Exeu/BLESEN/PCB.png

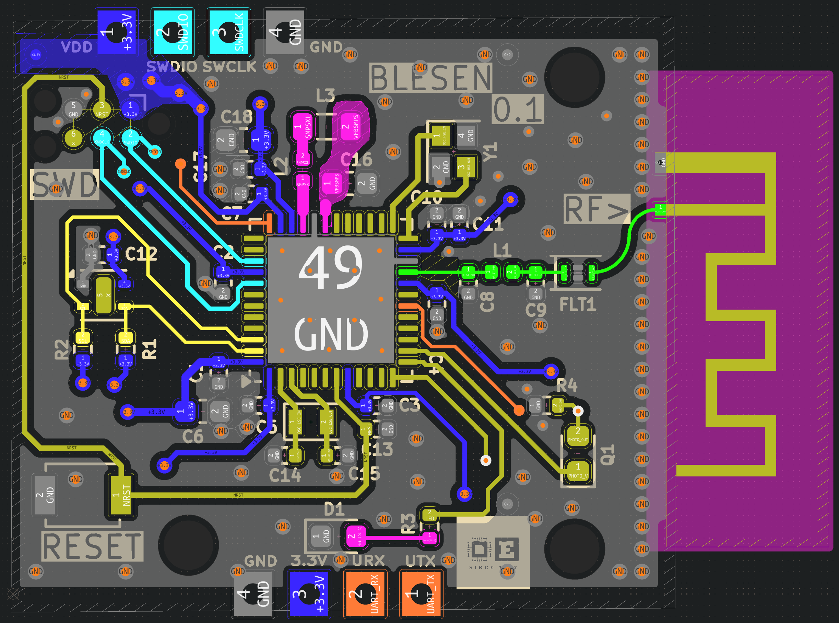
PCB.png
