Exeu/BLESEN/models/HT_CD_SHTC3_STEP_File_V1_D1 v2.step

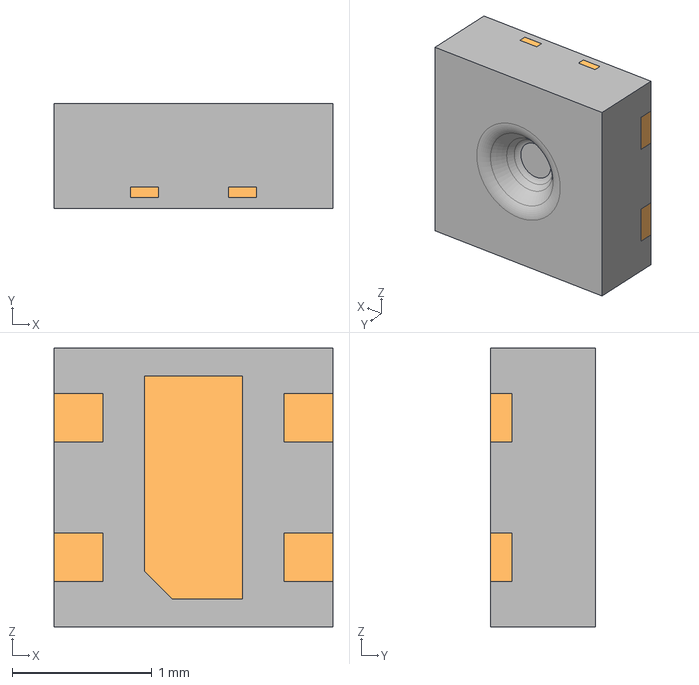
[picture p2: CAD file, 2025-02-23]
models/HT_CD_SHTC3_STEP_File_V1_D1 v2.step
2.00 x 0.75 x 2.00 mm
