Exeu/BLESEN/(list of files, cad)

Other CAD files:
models/HT_CD_SHTC3_STEP_File_V1_D1.STEP
