Exeu/BLESEN/BLESEN-Schematic.pdf

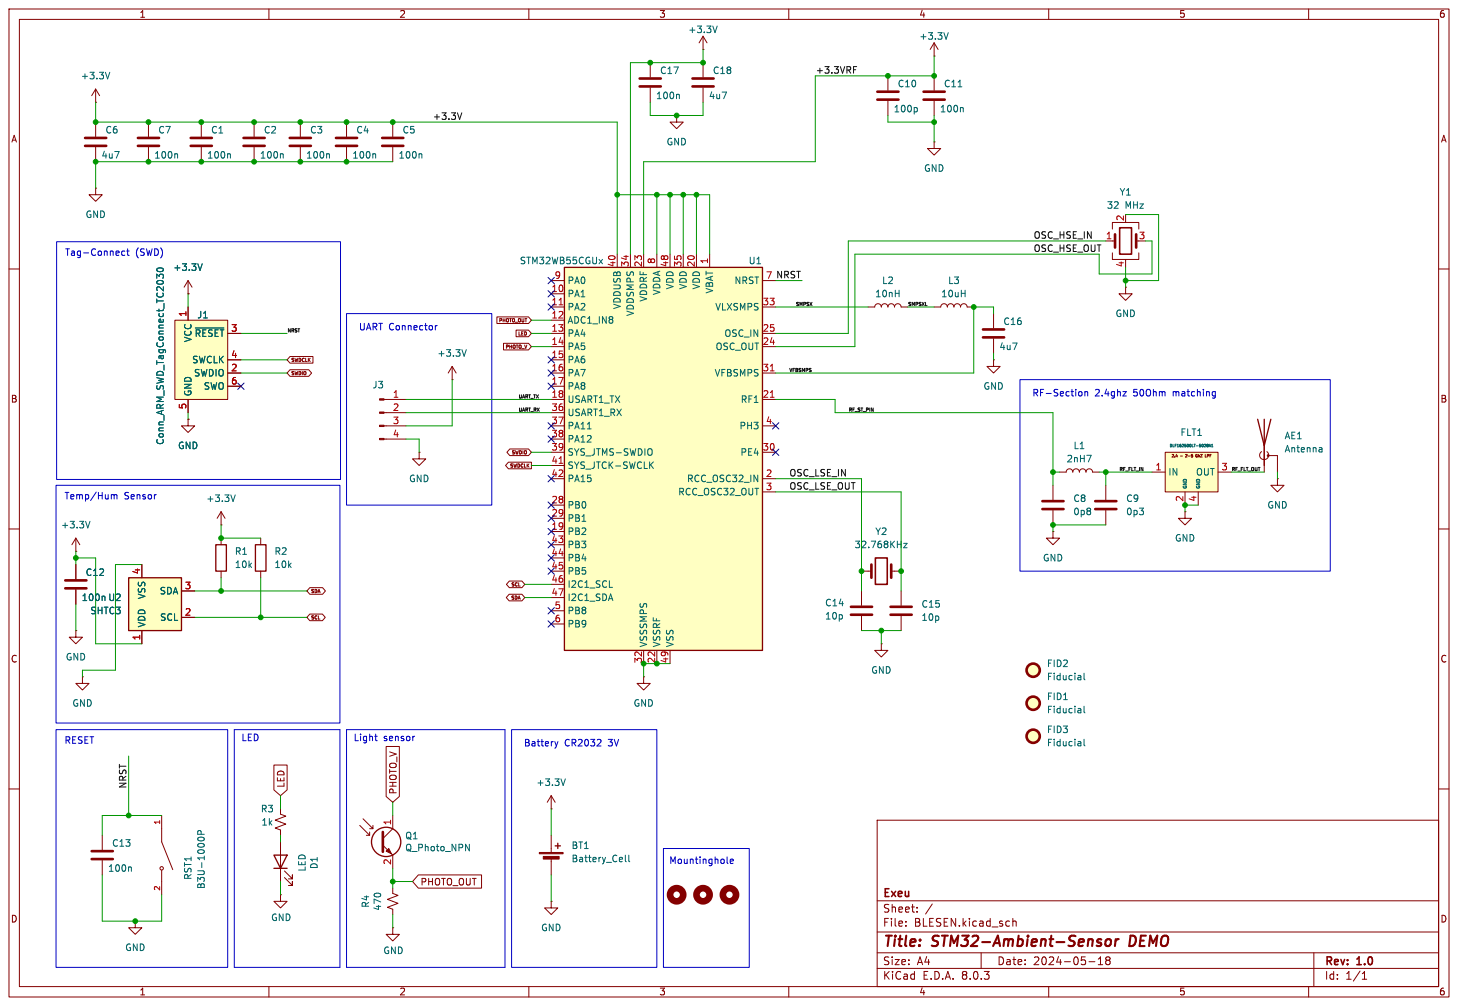
[picture p3: page 1]

1 PA1 10 PA2 11 ADC1_IN8 12 PA4 13 PA5 14 PA6 15 PA7 16 PA8 17 USART1_TX 18 PB2 19 RCC_OSC32_IN 2 VDD 20 RF1 21 VSSRF 22 VDDRF 23 OSC_OUT 24 OSC_IN 25 PB0 28 PB1 29 RCC_OSC32_OUT 3 PE4 30 VFBSMPS 31 VSSSMPS 32 VLXSMPS 33 VDDSMPS 34 VDD 35 USART1_RX 36 PA11 37 PA12 38 SYS_JTMS-SWDIO 39 PH3 4 VDDUSB 40 SYS_JTCK-SWCLK 41 PA15 42 PB3 43 PB4 44 PB5 45

1 SWDIO 2 ~{RESET}3 SWCLK 4 GND

File: BLESEN.kicad_sch Sheet: / Exeu
