Exeu/BLESEN/BLESEN.kicad_pcb

## KiCad design BLESEN.kicad_pcb (2025-06-20)

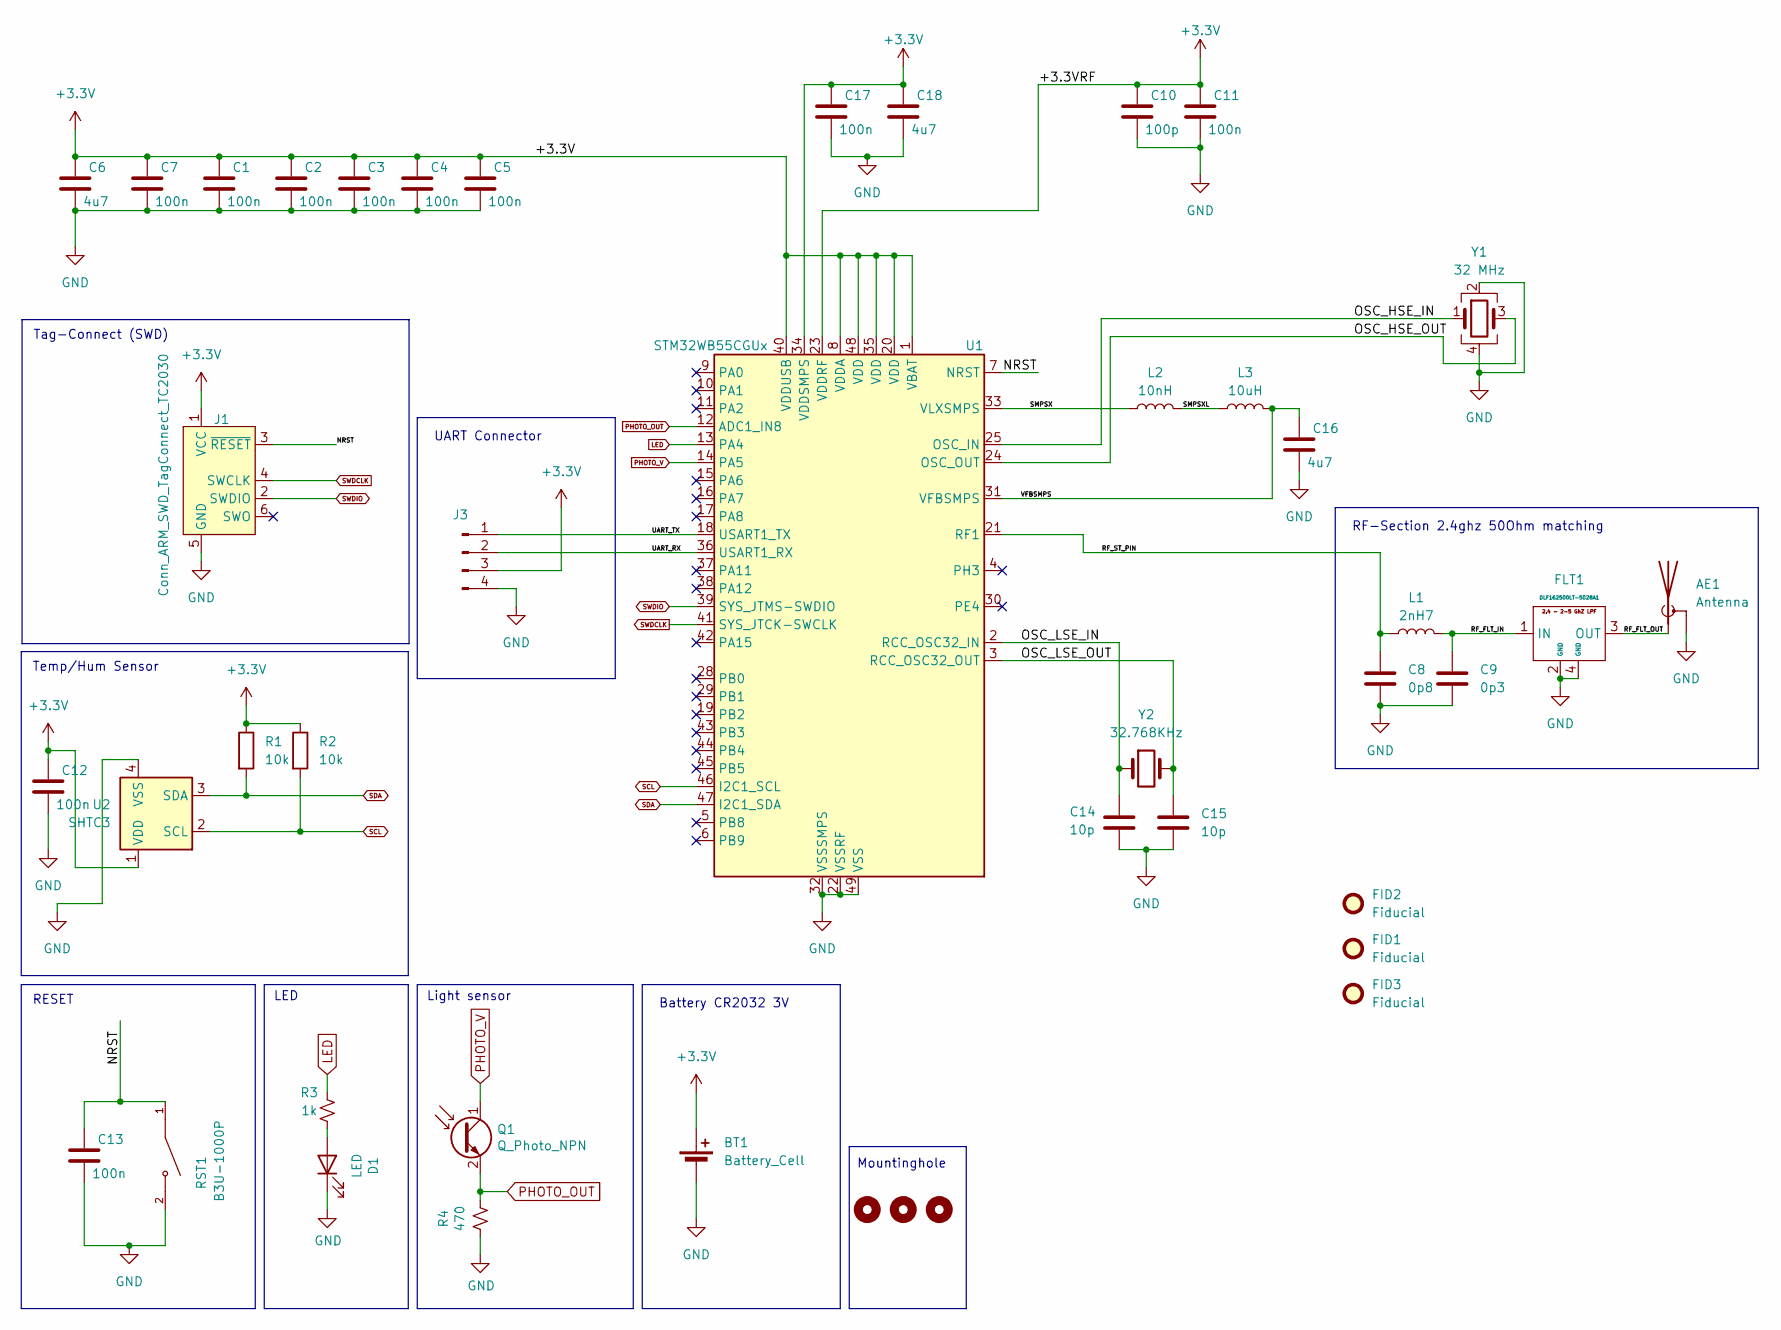
[picture p4: schematic BLESEN.kicad_sch, STM32-Ambient-Sensor - BLESEN]

Parts:
AE1: Antenna; Texas_SWRA117D_2.4GHz_Right
BT1: Battery_Cell; BatteryHolder_MPD_BC2003_1x2032
C1, C2, C3, C4, C5, C7, C11, C12, C13, C17: 100n; C_0402_1005Metric; LCSC C1525
C6, C16, C18: 4u7; C_0603_1608Metric; LCSC C19666
C8: 0p8; C_0402_1005Metric; LCSC C327032
C9: 0p3; C_0402_1005Metric; LCSC C76909
C10: 100p; C_0402_1005Metric; LCSC C77177
C14, C15: 10p; C_0402_1005Metric; LCSC C32949
D1: LED; LED_0603_1608Metric; LCSC C2286
FID1, FID2, FID3: Fiducial; Fiducial_0.5mm_Mask1mm
FLT1: DLF162500LT-5028A1; LCSC C531364
H2, H3, H4: MountingHole; MountingHole_2.2mm_M2_DIN965
J1: Conn_ARM_SWD_TagConnect_TC2030; Tag-Connect_TC2030-IDC-NL_2x03_P1.27mm_Vertical
J3: PinHeader_1x04_P2.00mm_Vertical
L1: 2nH7; L_0402_1005Metric; LCSC C434826
L2: 10nH; L_0402_1005Metric; LCSC C464435
L3: 10uH; L_0805_2012Metric; LCSC C98030
Q1: Q_Photo_NPN; D_0603_1608Metric; LCSC C146233
R1, R2: 10k; R_0402_1005Metric; LCSC C25744
R3: 1k; R_0402_1005Metric; LCSC C11702
R4: 470; R_0402_1005Metric; LCSC C25117
RST1: B3U-1000P; SW_SPST_B3U-1000P; LCSC C231329
U1: STM32WB55CGUx; QFN-48-1EP_7x7mm_P0.5mm_EP5.6x5.6mm; LCSC C404023
U2: SHTC3; Sensirion_DFN-4-1EP_2x2mm_P1mm_EP0.7x1.6mm; LCSC C194656
Y1: 32 MHz; Crystal_SMD_2016-4Pin_2.0x1.6mm; LCSC C843260
Y2: 32.768KHz; Crystal_SMD_2012-2Pin_2.0x1.2mm; LCSC C528982

Connections:
+3.3V: BT1.1 (+), C1.1, C2.1, C3.1, C4.1, C5.1, C6.1, C7.1, C10.1, C11.1, C12.1, C17.1, C18.1, J1.1 (VCC), J3.3, R1.1, R2.1, U1.1 (VBAT), U1.8 (VDDA), U1.20 (VDD), U1.23 (VDDRF), U1.34 (VDDSMPS), U1.35 (VDD), U1.40 (VDDUSB), U1.48 (VDD), U2.1 (VDD)
/NRST: C13.1, J1.3 (~RESET), RST1.1, U1.7 (NRST)
/OSC_HSE_IN: U1.25 (OSC_IN), Y1.1
/OSC_HSE_OUT: U1.24 (OSC_OUT), Y1.3
/OSC_LSE_IN: C14.1, U1.2 (RCC_OSC32_IN), Y2.1
/OSC_LSE_OUT: C15.1, U1.3 (RCC_OSC32_OUT), Y2.2
/RF_FLT_IN: C9.1, FLT1.1 (IN), L1.2
/RF_FLT_OUT: AE1.1 (A), FLT1.3 (OUT)
/RF_ST_PIN: C8.1, L1.1, U1.21 (RF1)
/SMPSX: L2.1, U1.33 (VLXSMPS)
/SMPSXL: L2.2, L3.1
/UART_RX: J3.2, U1.36 (USART1_RX)
/UART_TX: J3.1, U1.18 (USART1_TX)
/VFBSMPS: C16.1, L3.2, U1.31 (VFBSMPS)
GND: AE1.2 (Shield), BT1.2 (-), C1.2, C2.2, C3.2, C4.2, C5.2, C6.2, C7.2, C8.2, C9.2, C10.2, C11.2, C12.2, C13.2, C14.2, C15.2, C16.2, C17.2, C18.2, D1.1 (K), FLT1.2 (GND), FLT1.4 (GND), J1.5 (GND), J3.4, R4.1, RST1.2, U1.22 (VSSRF), U1.32 (VSSSMPS), U1.49 (VSS), U2.4 (VSS), Y1.2, Y1.4
LED: R3.2, U1.13 (PA4)
unnamed: D1.2 (A), R3.1
PHOTO_OUT: Q1.2 (E), R4.2, U1.12 (ADC1_IN8)
PHOTO_V: Q1.1 (C), U1.14 (PA5)
SCL: R2.2, U1.46 (I2C1_SCL), U2.2 (SCL)
SDA: R1.2, U1.47 (I2C1_SDA), U2.3 (SDA)
SWDCLK: J1.4 (SWCLK), U1.41 (SYS_JTCK-SWCLK)
SWDIO: J1.2 (SWDIO), U1.39 (SYS_JTMS-SWDIO)

Notes on the sheet:
LED
RESET
Mountinghole
RF-Section 2.4ghz 50Ohm matching
UART Connector
Light sensor
Battery CR2032 3V
Temp/Hum Sensor
Tag-Connect (SWD)

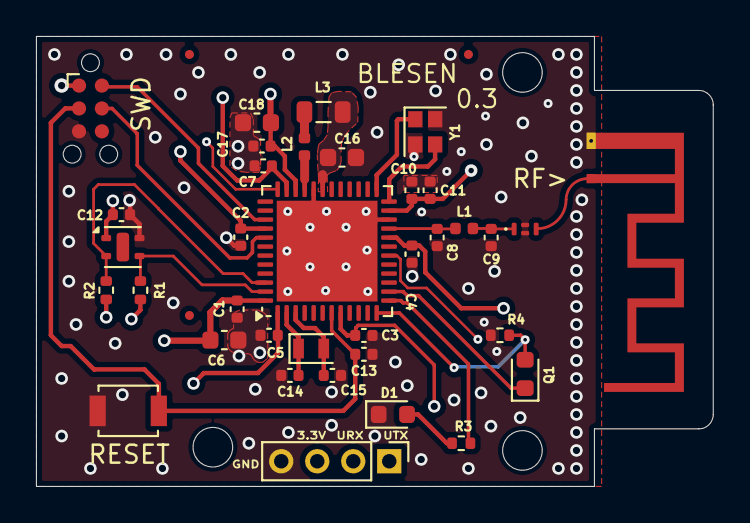
[picture p5: board BLESEN.kicad_pcb from above]

Board: 4 copper layers, 37.6 x 25.0 mm, 43 parts (1 on the bottom side), 23 nets.
